Fabrizio1992111/TrabajoFinalIngenieriaMec-nica/caratula tesis-converted.pdf

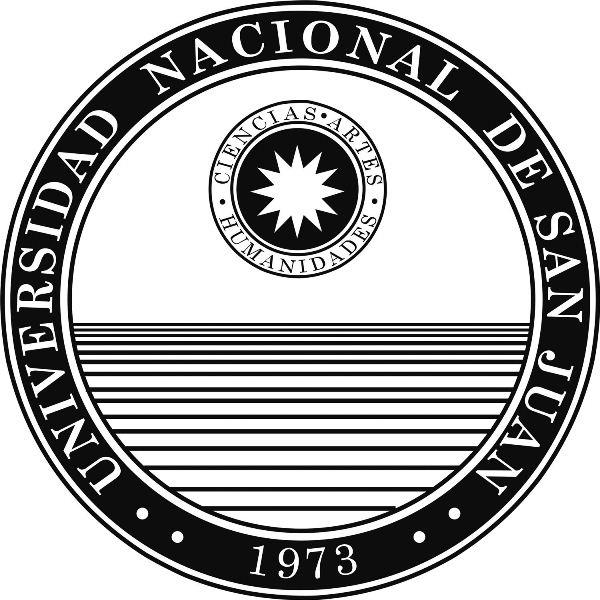
[picture p1: figure]

# FACULTAD DE INGENIERIA INGENIERÍA MECÁNICA

# TRABAJO FINAL

# “MECANISMO SEGUIDOR SOLAR CON MOVIMIENTO COMPLEJO”

PRESENTAN

Riveros López Mathias Ezequiel | Aguzzi Llubel Fabrizio Ezequiel
(Reg. 25002) | (Reg. 25670)

DIRECTOR DE TESIS

Ing. Guevara Carlos Manuel

Diciembre de 2018
