Fabrizio1992111/TrabajoFinalIngenieriaMec-nica/(list of files, cad)

Other CAD files:
TF-AR-18-02-02 TRIDENTE ENSAMBLE 2.dwg
TF-AR-18-02-01 TRIDENTE ENSAMBLE 1.dwg
TF-AR-18-01-04 PINZAS TIPO T.dwg
TF-AR-18-02-03 BASE DEL TRIDENTE.dwg
TF-AR-18-01-03 PINZAS TIPO S.dwg
TF-AR-18-01-06 ESQUINEROS.dwg
TF-AR-18-01-05 EMPALMES.dwg
TF-AR-18-01-01 ESTRUCTURA DE PANELES.dwg
TF-AR-18-02 PLANO TRIDENTE.dwg
